NBL-DPZ/PriMa/Human/README.md

Manipulandum Human:
Main body and two switch types as they are assembled

MRI-Mount:
Mount for the patient bed of the Siemens Prism scanner. Only custom designed parts are the feet, which slot into the grooves left and right of the paitent.

SNRrecordings:
Functional scans of the spherical phantom (Siemens)
