NBL-DPZ/PriMa/ControlBox/README.md

Mounting frame for the photo diods and LEDs to connect to the control box
