NBL-DPZ/PriMa/Connector/README.md

Print in place for parts "Buchse" and "Ring" is recomended
