NBL-DPZ/PriMa/PartList.ods

Controller Box
Description | Quantity | Price | Link
Printed Circuit Board | 1 | 50.00 EUR
Box Connector Mount* | 1 | 29.17 EUR
Enclosure | 1 | 6.25 EUR | https://www.reichelt.de/gehaeuse-serie-mini-cab-abs-85-x-80-x-36-mm-weiss-teko-mc-11-7-p269736.html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 (not the exact one)
DSUB 25 Pin | 1 | 5.33 EUR | https://www.conrad.de/de/p/harting-09-68-363-5812-d-sub-stiftleiste-90-polzahl-25-loeten-1-st-799023.html
BNC Connector | 1 | 1.99 EUR | https://www.conrad.de/de/p/bnc-steckverbinder-buchse-einbau-vertikal-50-1-st-1564888.html
2.1mm DC Jack | 1 | 3.97 EUR | https://www.conrad.de/de/p/niedervolt-steckverbinder-buchse-einbau-vertikal-5-5-mm-2-1-mm-1-st-1564886.html
5V Power Adapter | 1 | 10.99 EUR | https://www.conrad.de/de/p/goobay-54805-schaltnetzteil-uebertrager-5-v-1-a-5-w-1973040.html
Terminal Header Part 1 (5 pole) | 1 | 0.35 EUR | https://www.reichelt.de/stiftleiste-5-pol-rm-5-mm-90-rnd-205-00169-p170469.html?&trstct=pos_0&nbc=1
Terminal Header Part 2 (5 pole) | 1 | 0.60 EUR | https://www.reichelt.de/steckbare-schraubklemme-5-pol-rm-5-08-mm-0-rnd-205-00180-p170413.html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
Schrauben M3x5mm | 20 | 0.90 EUR | https://www.conrad.de/de/p/toolcraft-1061816-zylinderschrauben-m3-5-mm-innensechskant-din-912-edelstahl-a2-100-1061816.html
LED High Power White | 10 | 0.95 EUR | https://www.conrad.de/de/p/broadcom-asmt-qwbe-nfhde-smd-led-plcc4-neutral-weiss-120-150-ma-3-6-v-tape-cut-180680.html
LED Yellow | 10 | 0.15 EUR | https://www.conrad.de/de/p/tru-components-1573743-led-bedrahtet-gelb-rund-5-mm-130-mcd-50-20-ma-2-1-v-1573743.html
LED Green | 1 | 0.15 EUR | https://www.conrad.de/de/p/tru-components-1573746-led-bedrahtet-gruen-rund-5-mm-38-mcd-50-20-ma-2-1-v-1573746.html
Photodiode | 10 | 0.74 EUR | https://www.conrad.de/de/p/osram-fotodiode-5-mm-1100-nm-20-sfh-154002.html
74HC14 Schmitt Inverter | 2 | 0.22 EUR | https://www.reichelt.de/inverter-hex-2-6-v-dil-14-74hc-14-p3140.html?&trstct=pos_0&nbc=1
TLC272 Operational Amplifier | 10 | 2.10 EUR | https://www.reichelt.de/operationsverstaerker-2-fach-dip-8-tlc-272-ip-p188980.html?trstct=pol_7&nbc=1
pChannel Mosfet | 1 | 0.25 EUR | https://www.reichelt.de/mosfet-p-ch-20v-4a-1-5w-sot-23-ao-3415a-p166474.html?&trstct=pos_0&nbc=1
Potentiometer 5M | 10 | 0.28 EUR | https://www.reichelt.de/einstellpotentiometer-liegend-5-0-mohm-10-mm-pt-10-l-5-0m-p14628.html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
Zener Diode | 1 | 0.06 EUR | https://www.reichelt.de/zenerdiode-7-5-v-1-3-w-do-204al-do41-zd-7-5-p23099.html?&trstct=pos_0&nbc=1
Resistors
100k | 10 | 0.04 EUR | https://www.reichelt.de/smd-widerstand-1206-100-kohm-250-mw-5-smd-1-4w-100k-p18243.html?trstct=pos_0&nbc=1
3M | 10 | 0.04 EUR | https://www.reichelt.de/smd-widerstand-1206-3-0-mohm-250-mw-5-smd-1-4w-3-0m-p18300.html?trstct=pos_0&nbc=1
220k | 10 | 0.04 EUR | https://www.reichelt.de/smd-widerstand-1206-220-kohm-250-mw-5-smd-1-4w-220k-p18288.html?trstct=pos_0&nbc=1
22k | 10 | 0.04 EUR | https://www.reichelt.de/smd-widerstand-1206-22-kohm-250-mw-5-smd-1-4w-22k-p18289.html?trstct=pos_0&nbc=1
75R | 11 | 0.04 EUR | https://www.reichelt.de/smd-widerstand-1206-75-ohm-250-mw-5-smd-1-4w-75-p18371.html?trstct=pos_0&nbc=1
150R | 10 | 0.04 EUR | https://www.reichelt.de/smd-widerstand-1206-150-ohm-250-mw-5-smd-1-4w-150-p18259.html?trstct=pos_0&nbc=1
10k | 1 | 0.04 EUR | https://www.reichelt.de/smd-widerstand-1206-10-kohm-250-mw-5-smd-1-4w-10k-p18244.html?trstct=pos_0&nbc=1
1M | 10 | 0.04 EUR | https://www.reichelt.de/smd-widerstand-1206-1-0-mohm-250-mw-5-smd-1-4w-1-0m-p18222.html?trstct=pos_0&nbc=1
2M | 10 | 0.04 EUR | https://www.reichelt.de/smd-widerstand-1206-2-0-mohm-250-mw-5-smd-1-4w-2-0m-p18272.html?trstct=pos_0&nbc=1
6,8M | 10 | 0.04 EUR | https://www.reichelt.de/smd-widerstand-1206-6-8-mohm-250-mw-5-smd-1-4w-6-8m-p18359.html?trstct=pos_0&nbc=1
Capacitors
100n | 12 | 0.05 EUR | https://www.reichelt.de/smd-vielschicht-keramikkondensator-100n-10-x7r-g1206-100n-p22889.html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
470n | 2 | 0.24 EUR | https://www.reichelt.de/vielschicht-kerko-470nf-50v-125-c-kem-x7r1206-470n-p207158.html?trstct=pos_0&nbc=1
Total Price Controller Box |  | 174.51 EUR
Manipulandum Human
Description | Quantity | Price | Link
Manipulandum
Body* | 1 | 224.14 EUR
Button Big* | 2 | 6.90 EUR
Button Small* | 4 | 6.90 EUR
Cableclamp* | 2 | 11.97 EUR
Plastic Screw M4x10mm | 8 | 0.19 EUR | https://www.conrad.de/de/p/toolcraft-815837-zylinderschrauben-m4-10-mm-schlitz-din-84-iso-1207-kunststoff-polyamid-10-815837.html
MRI Mount
CFK Pipe 18mm | 3 | 20.50 EUR | https://shop1.r-g.de/art/740908
Pipe Connector | 10 | 1.67 EUR | https://www.kippwerk.de/de/de/Produkte/Bedienteile-Normelemente/Rohrverbindungselemente-Profilverbinder/K0472-Kreuzklemmst%C3%BCcke-Kunststoff.html
Pipe Connector Adjustable Angle | 6 | 2.37 EUR | https://www.kippwerk.de/de/de/Produkte/Bedienteile-Normelemente/Rohrverbindungselemente-Profilverbinder/K0488-Gelenkklemmst%C3%BCcke-Kunststoff-ohne-Verzahnun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
Rail Mounting Feet* | 4 | 23.32 EUR
Plastic Screw M6x20mm | 28 | 0.23 EUR | https://www.conrad.de/de/p/toolcraft-830325-zylinderschrauben-m6-20-mm-innensechskant-din-912-kunststoff-polyamid-10-830325.html
Plastic Nut M6 | 28 | 0.17 EUR | https://www.conrad.de/de/p/toolcraft-815993-sechskantmuttern-m6-kunststoff-10-815993.html
Cables and Connectors
Fibre Optic Cable (per meter) | 60 | 1.77 EUR | https://www.conrad.de/de/p/lapp-28020001-pof-kabel-hitronic-pof-980-1000-simplex-orange-607461.html
Controller Box Plug Matrix* | 1 | 34.40 EUR
Female Cable Connector Matrix* | 1 | 83.21 EUR
Male Cable Connector Matrix* | 1 | 57.15 EUR
Total Price Manipulandum Human |  | 768.86 EUR
Manipulandum Monkey
Description | Quantity | Price | Link
Manipulandum
Body* | 1 | 156.23 EUR
Button_Big* | 2 | 6.90 EUR
Button Small* | 4 | 6.90 EUR
Support Body* | 1 | 38.24 EUR
Support Clamp* | 1 | 8.95 EUR
Plastic Screw M4x10mm | 8 | 0.19 EUR | https://www.conrad.de/de/p/toolcraft-815837-zylinderschrauben-m4-10-mm-schlitz-din-84-iso-1207-kunststoff-polyamid-10-815837.html
Handrest
Buttons* | 1 | 6.90 EUR
Housing Body* | 1 | 21.82 EUR
Housing Cable Clamp Left* | 1 | 6.90 EUR
Housing Cable Clamp Right* | 1 | 6.90 EUR
Plastic Screw M4x10mm | 4 | 0.19 EUR | https://www.conrad.de/de/p/toolcraft-815837-zylinderschrauben-m4-10-mm-schlitz-din-84-iso-1207-kunststoff-polyamid-10-815837.html
Cables and Connectors
Fibre Optic Cable (per meter) | 30 | 1.77 EUR | https://www.conrad.de/de/p/lapp-28020001-pof-kabel-hitronic-pof-980-1000-simplex-orange-607461.html
Controller Box Plug Matrix* | 1 | 34.40 EUR
Total Price Manipulandum Monkey |  | 377.12 EUR
Total Price Human MRI Setup |  | 943.37 EUR
Total Price Monkey MRI Setup |  | 551.63 EUR
* 3D printed Parts
Assembly Times
Description | Hours
Controller Box | 10
Manipulandum Monkey | 4
Manipulandum Human | 4
Cables | 2
