NBL-DPZ/PriMa/6ButtonBox/SwitchBox.step

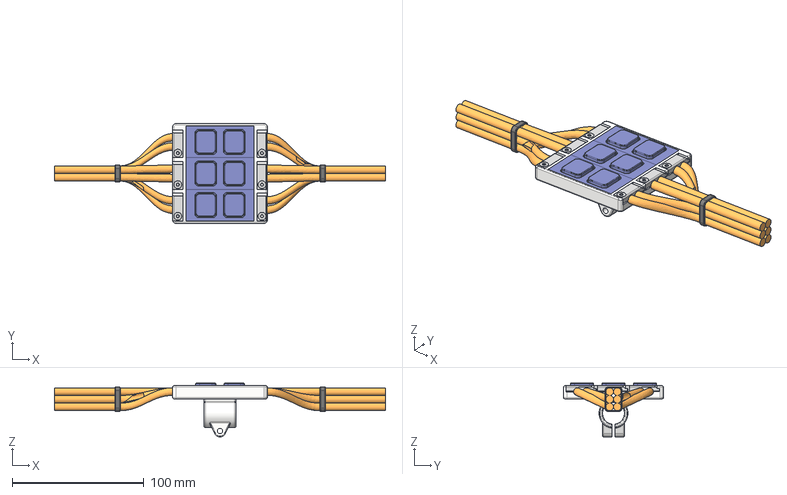
[picture p1: CAD file, 2021-03-25]
6ButtonBox/SwitchBox.step
251.7 x 76.0 x 40.9 mm
Switch x 3
Clamp
91294A128 x 6
Cable Ties
