NBL-DPZ/PriMa/Connector/FibreopticCableConnector.step

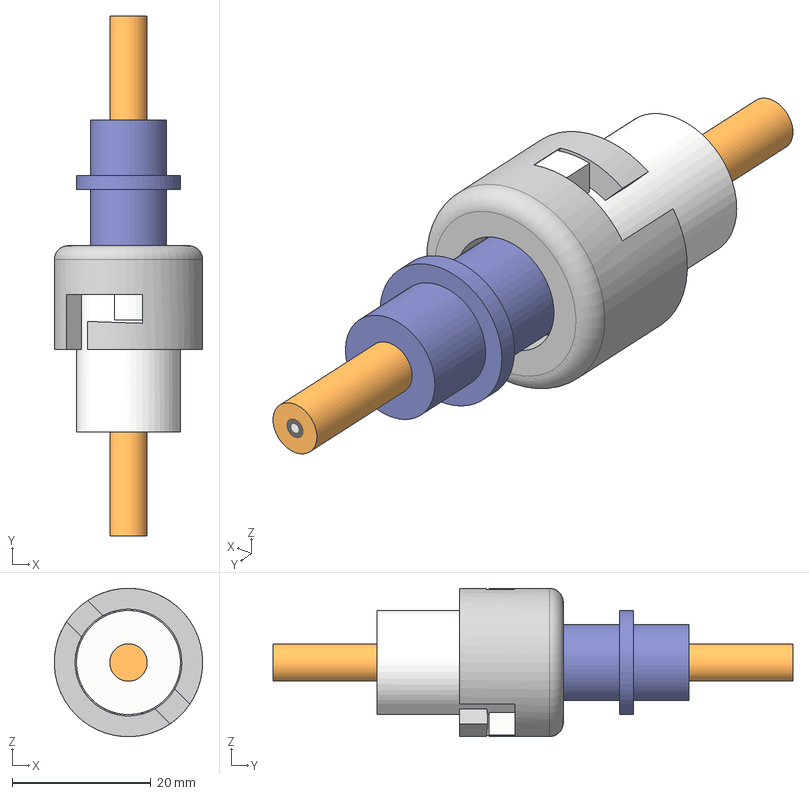
[picture p2: CAD file, 2021-01-18]
Connector/FibreopticCableConnector.step
21.4 x 75.0 x 21.4 mm
Stecker
Buchse
Ring
Cables
