NBL-DPZ/PriMa/ControlBox/BoxConnector.step

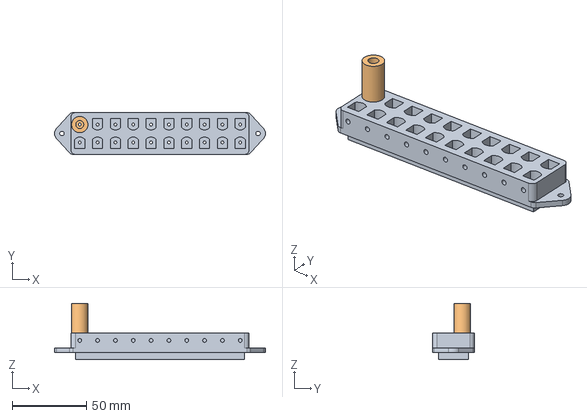
[picture p3: CAD file, 2021-01-18]
ControlBox/BoxConnector.step
142.0 x 28.0 x 38.0 mm
Mount
Plug
