NBL-DPZ/PriMa/Human/MRI-Mount.step

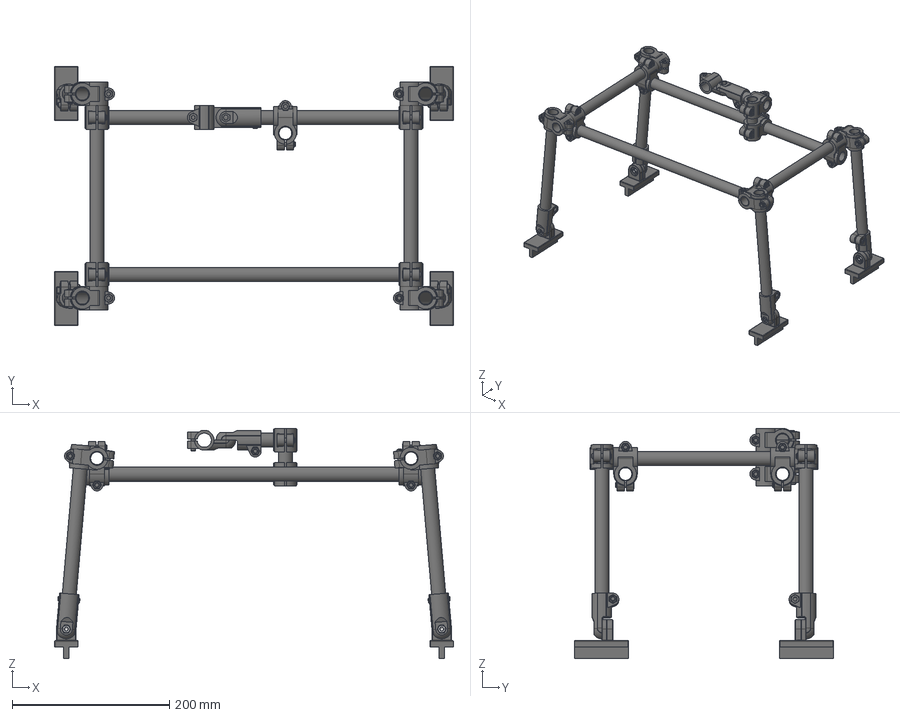
[picture p4: CAD file, 2021-01-18]
Human/MRI-Mount.step
508.2 x 330.0 x 293.2 mm
K0472.1818 x 10
Crossbar 1
Crossbar 2
Crossbar 3
Crossbar 4
Leg 1
Leg 2
_K0488 x 4
_K1148 x 4
_K0869 x 4
MRI Table Mount x 4
Leg 3
Leg 4
Mounting Bar
_K0488_1
_K0486
Mounting Bar 2
