NBL-DPZ/PriMa/Macaque/ManipulandumMacaque.step

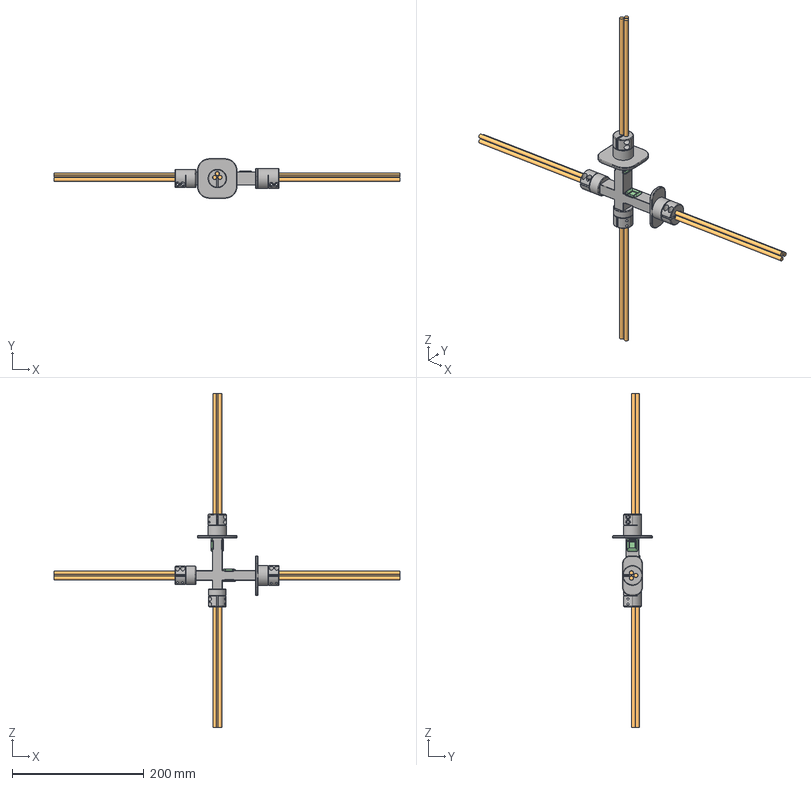
[picture p5: CAD file, 2021-01-18]
Macaque/ManipulandumMacaque.step
524.3 x 60.0 x 506.2 mm
Schalter_klein1
Schalter_klein2
Schalter_groß v7
Schalter_groß v7 (1)
Schalter_klein3
Schalter_klein4
Cables
Screw Clamp
