NBL-DPZ/PriMa/Human/ManipulandumHuman.step

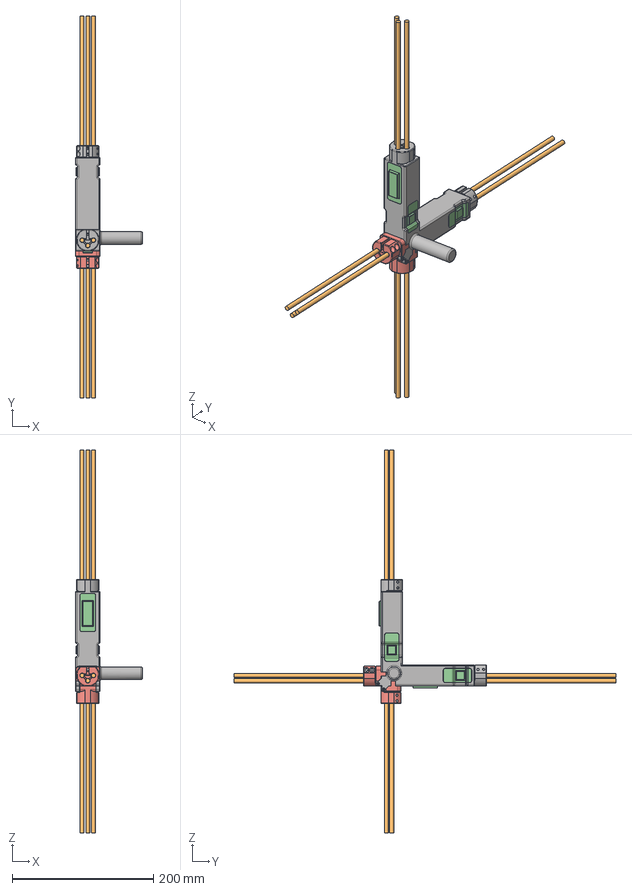
[picture p6: CAD file, 2021-01-18]
Human/ManipulandumHuman.step
95.0 x 540.0 x 542.0 mm
Switch Small x 4
Switch Big x 2
Cableholder x 2
Body_V2
Cables
Screw clamp x 8
Screw Cableholder x 4
