NBL-DPZ/PriMa/(list of files, cad)

Other CAD files:
6ButtonBox/SwitchBox.f3d
Connector/FibreopticCableConnector.f3d
ControlBox/BoxConnector.f3d
Human/MRI-Mount.f3z
