NBL-DPZ/PriMa/(commit log)

2021-01-18 Create .gitkeep
    placeholder for Light fiber connector folder
2021-01-18 Add files via upload
    Added human Manipulandum
    [ManipulandumHuman.step]
2021-01-18 Add files via upload
    Reupload in correct folder
    [ManipulandumHuman.step]
2021-01-18 Add files via upload
    Uploaded human MRI mounting structure
    [MRI-Mount.f3z, MRI-Mount.step]
2021-01-18 Add files via upload
    Uploaded Cable Connector files
    [FibreopticCableConnector.f3d, FibreopticCableConnector.step]
2021-01-18 Add files via upload
    Uploaded Macaque Manipulandum
    [ManipulandumMacaque.step]
2021-01-18 Add files via upload
    Macaque Handrest uploaded
    [Handrest.step]
2021-01-19 Fixed Macaque Manipulandum and added parts list
    [Handrest.step, PartList.ods]
2021-03-25 Upload 6ButtonBox
    [SwitchBox.f3d, SwitchBox.step]
